PLSCO/Glowdeck_PCB/Images/Glowdeck PCB Image v1.01.jpg

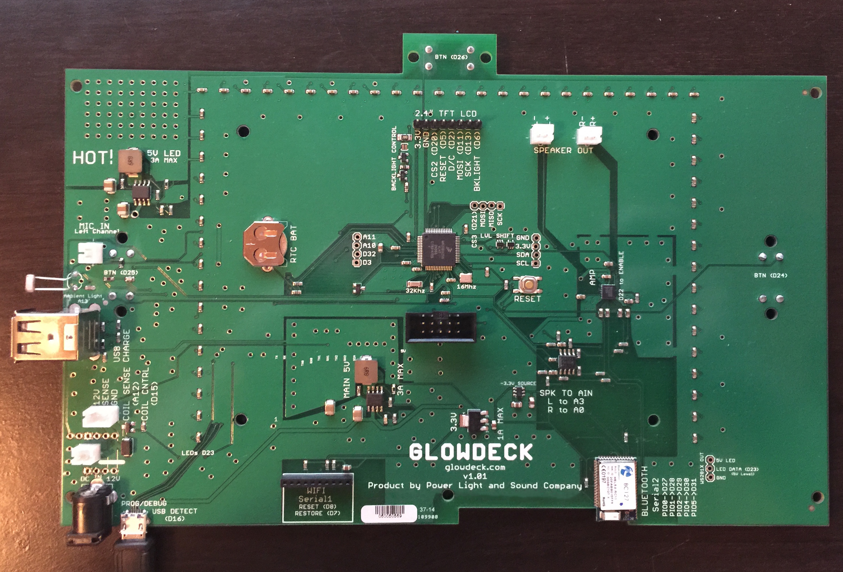
Images/Glowdeck PCB Image v1.01.jpg
