PLSCO/Glowdeck_PCB/README.md

# Glowdeck_PCB
Glowdeck circuit board design and layout
