PLSCO/Glowdeck_PCB/Schematic/Glowdeck PCB Schematic v1.01.pdf

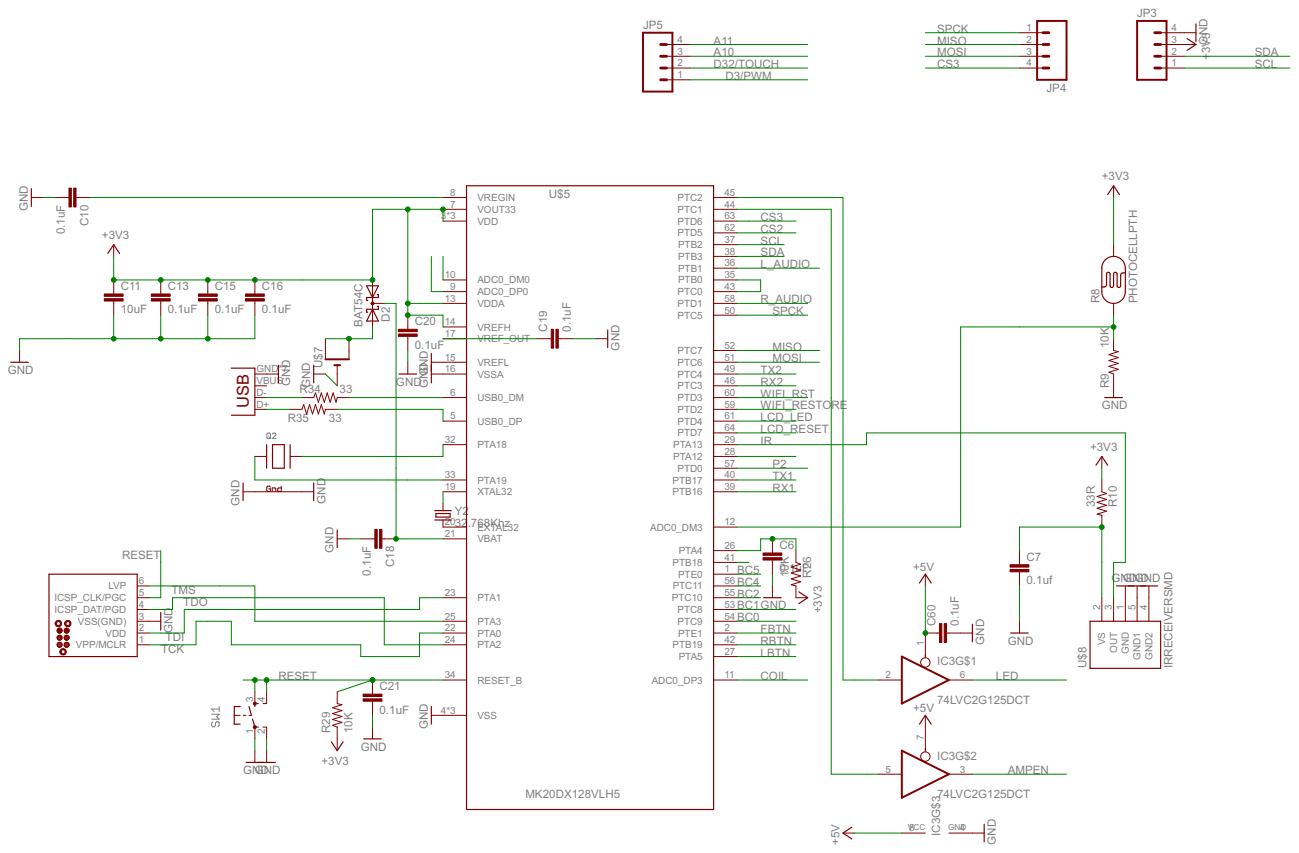
[picture p2: page 1]

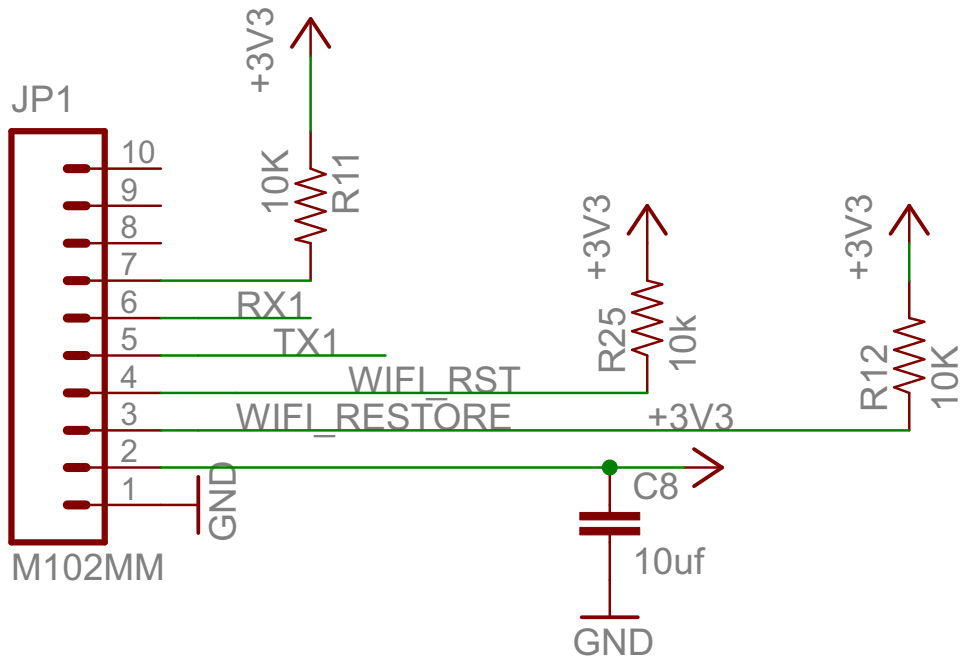
[picture p3: page 2]

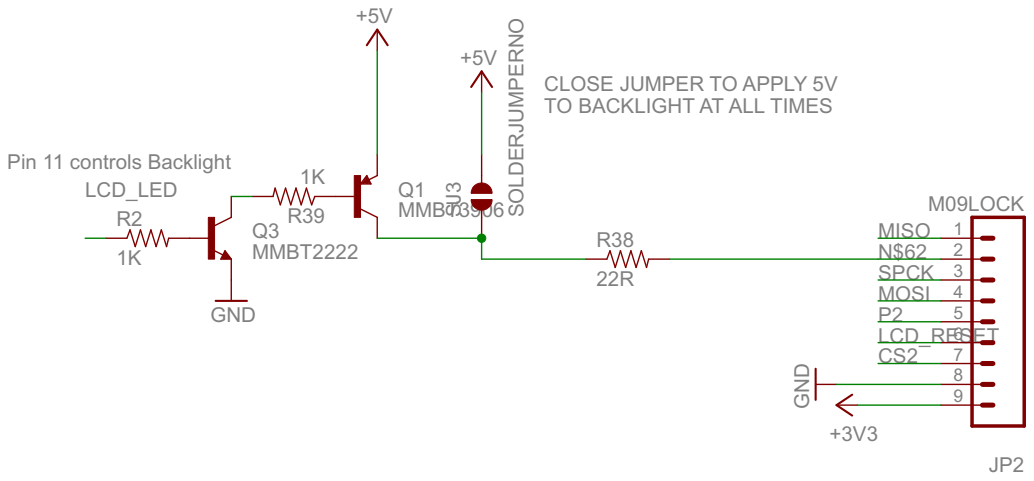
[picture p4: page 3]

CLOSE JUMPER TO APPLY 5V
TO BACKLIGHT AT ALL TIMES

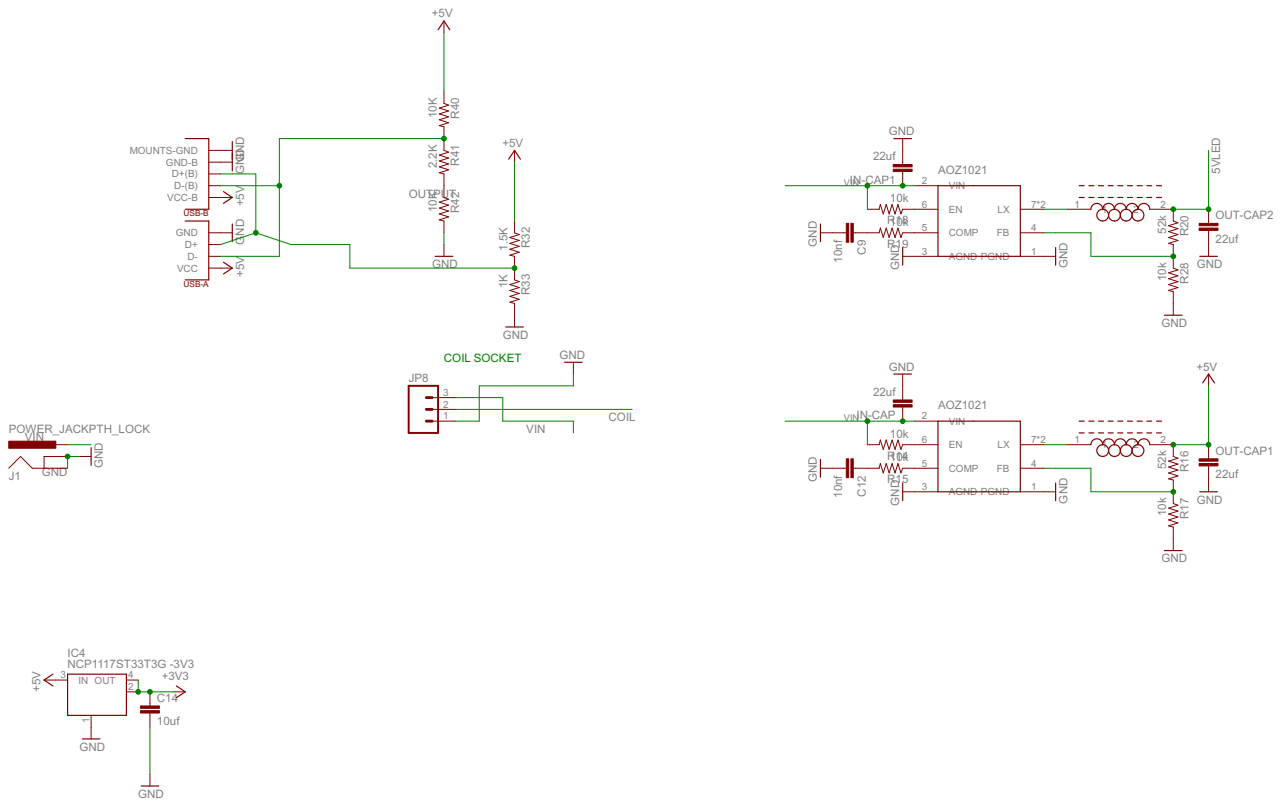
[picture p5: page 4]

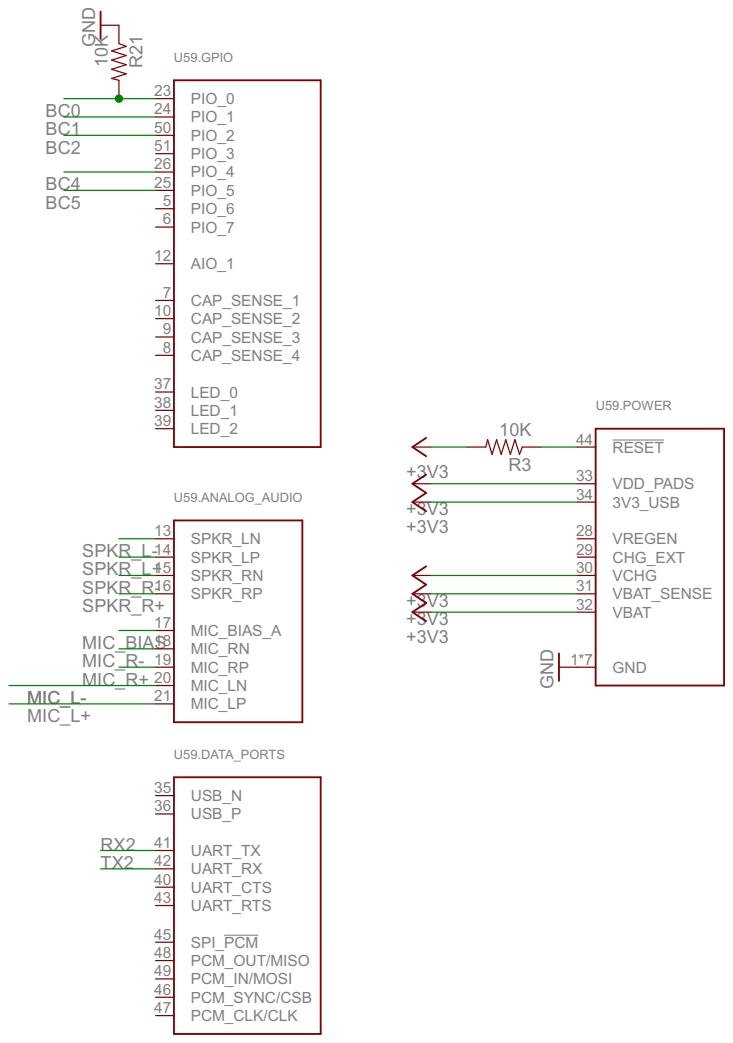
[picture p6: page 5]

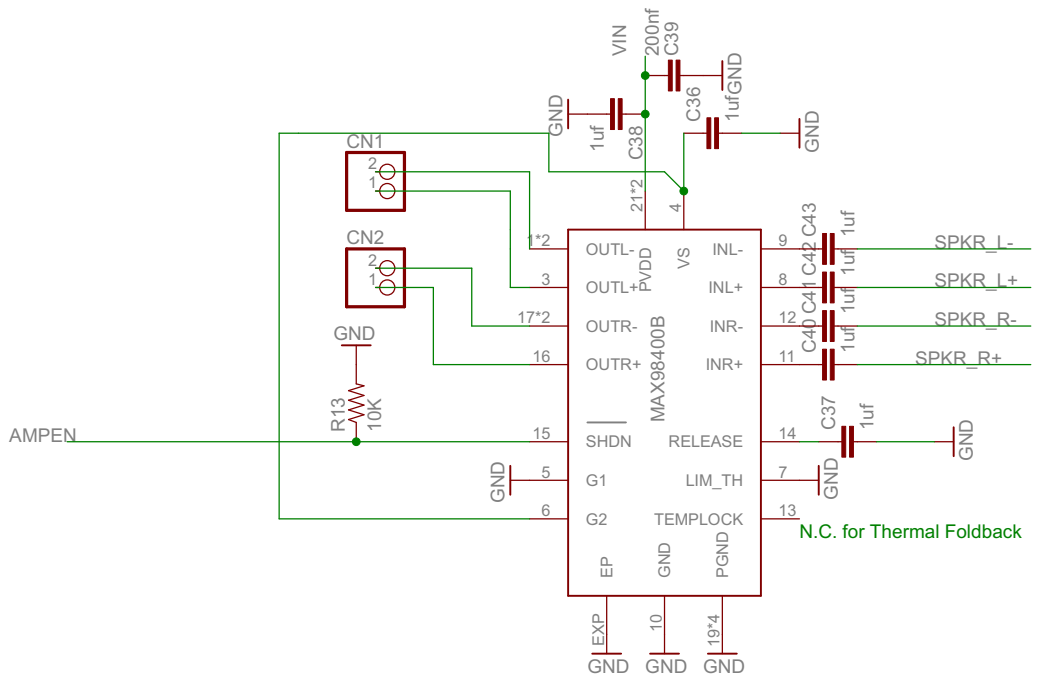
[picture p7: page 6]

1uf 1uf 1uf GND GND GND GND GND GND GND GND200nf 10K 1uf 1uf 1uf 1uf GND GND OUTL- 1*2 OUTL+ 3 OUTR- 17*2 OUTR+ 16 SHDN 15 G1 5 G2 6 TEMPLOCK 13 LIM_TH 7 RELEASE 14 INR+ 11 INR- 12 INL+ 8 INL- 9 VS 4 PVDD 21*2 GND 10 PGND 19*4 EP EXP MAX98400B C36 C37 C38 C39 R13 C40 C41 C42 C43 CN121 CN221 AMPEN SPKR_R+ SPKR_R- SPKR_L+ SPKR_L- VIN N.C. for Thermal Foldback

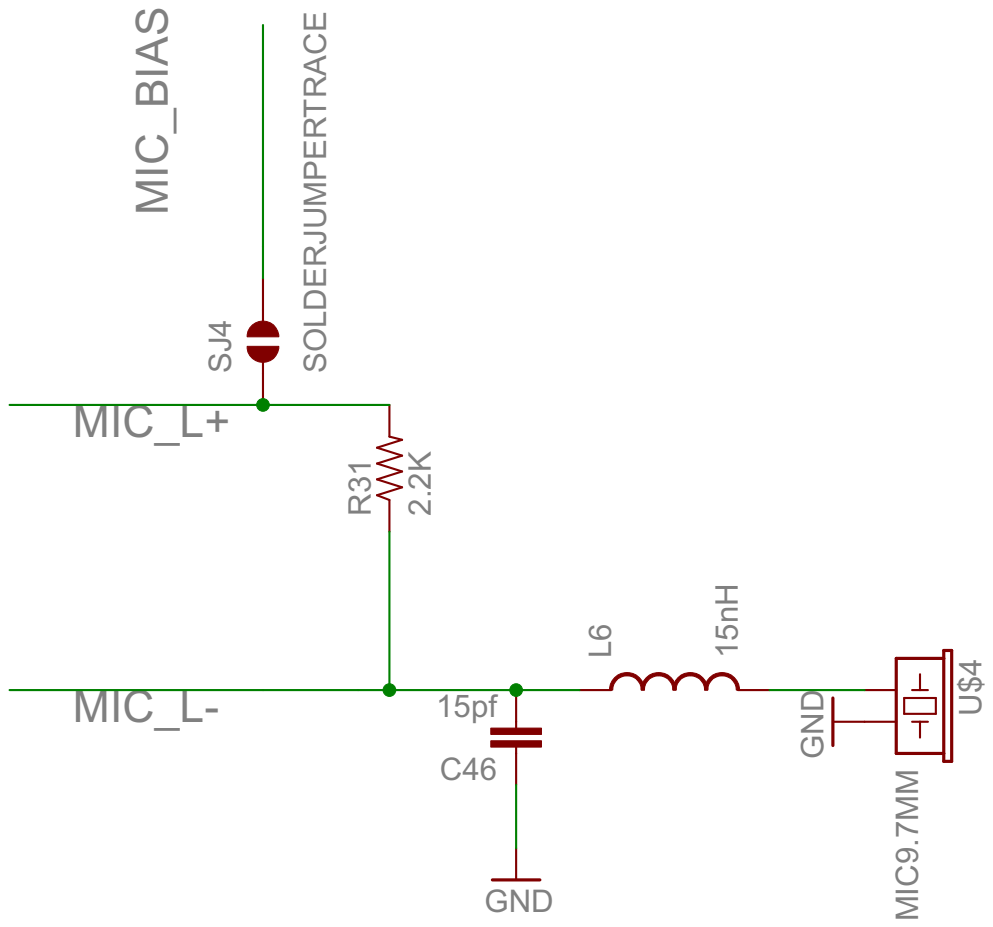
[picture p8: page 7]

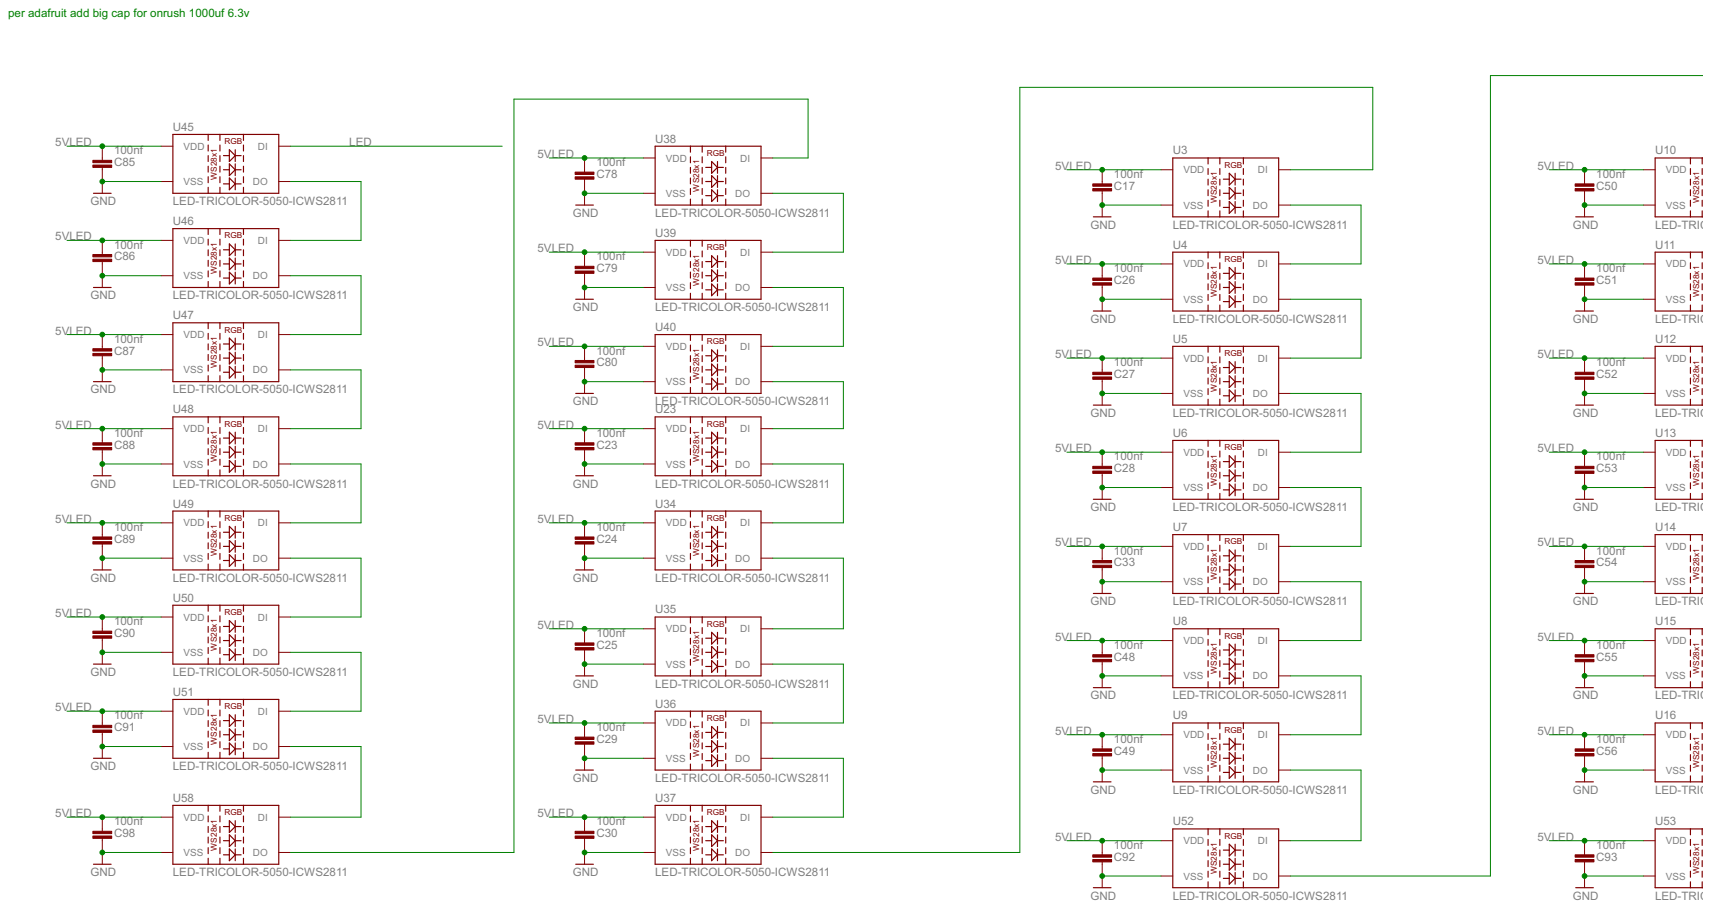
[picture p9: page 8]

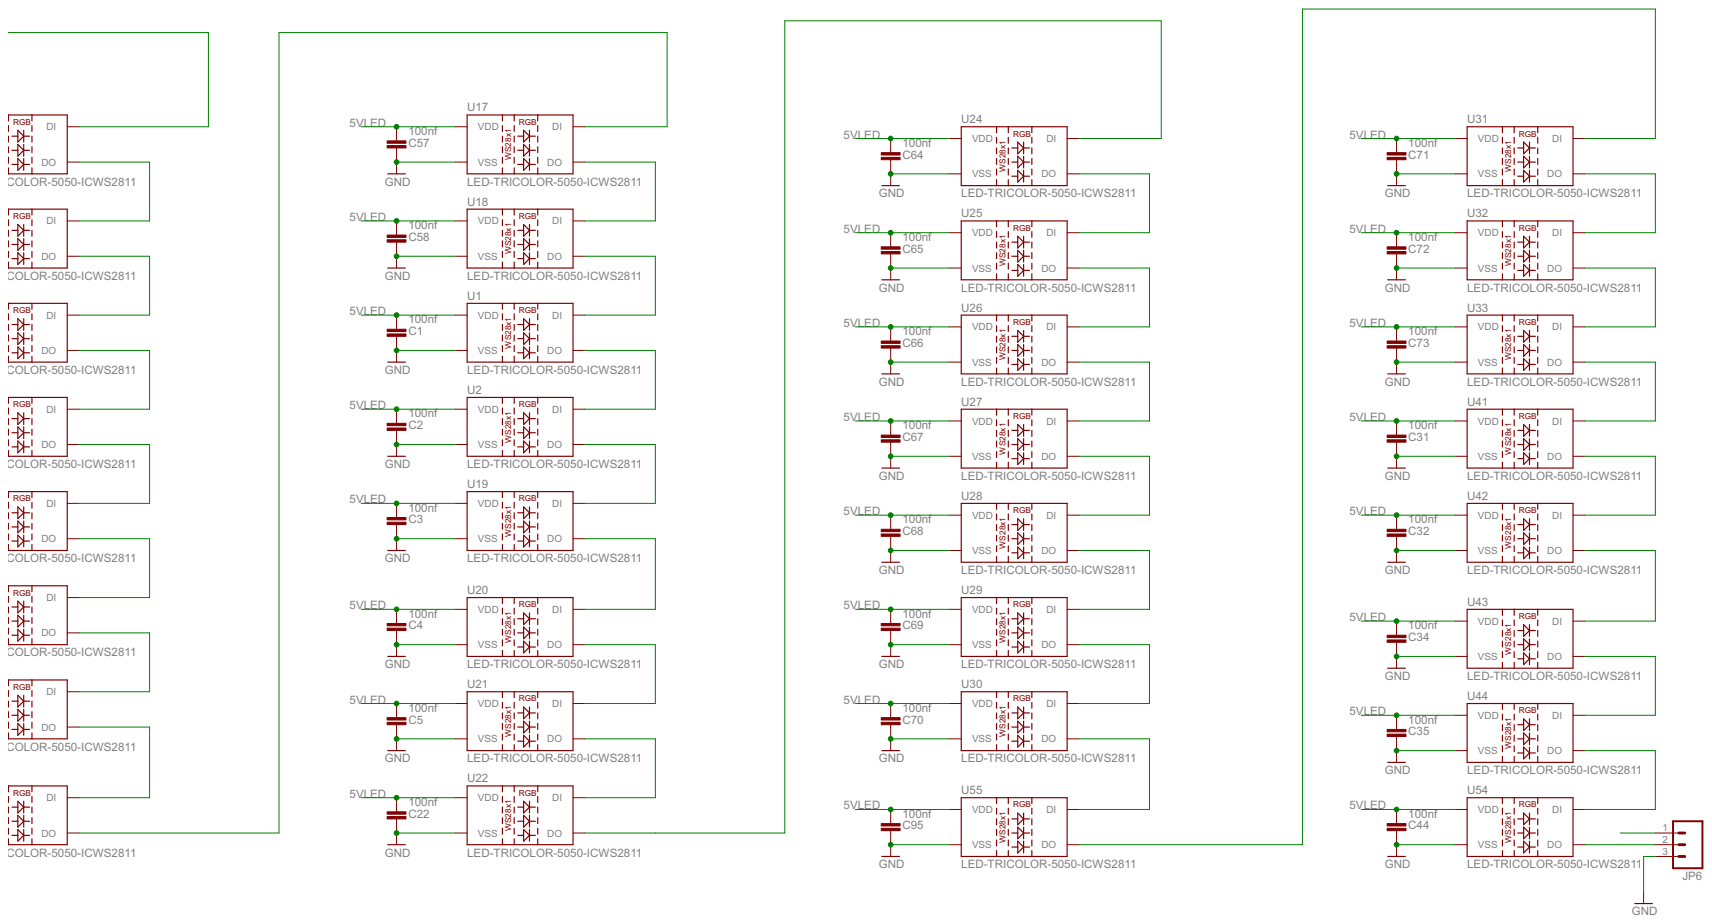
[picture p10: page 9]

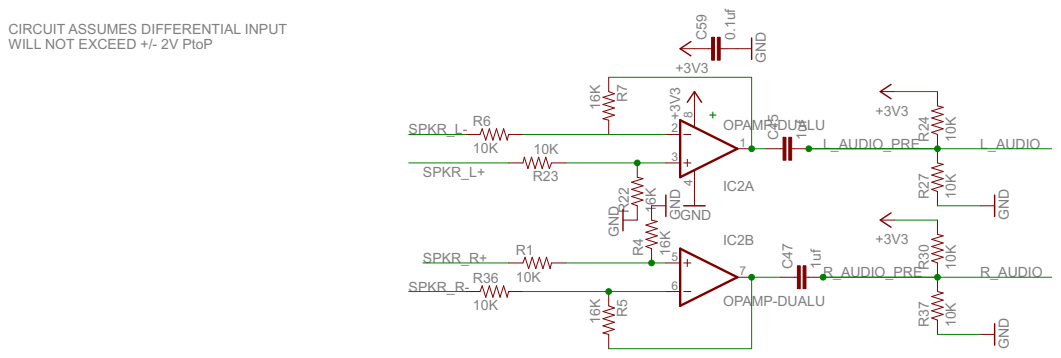
[picture p11: page 10]

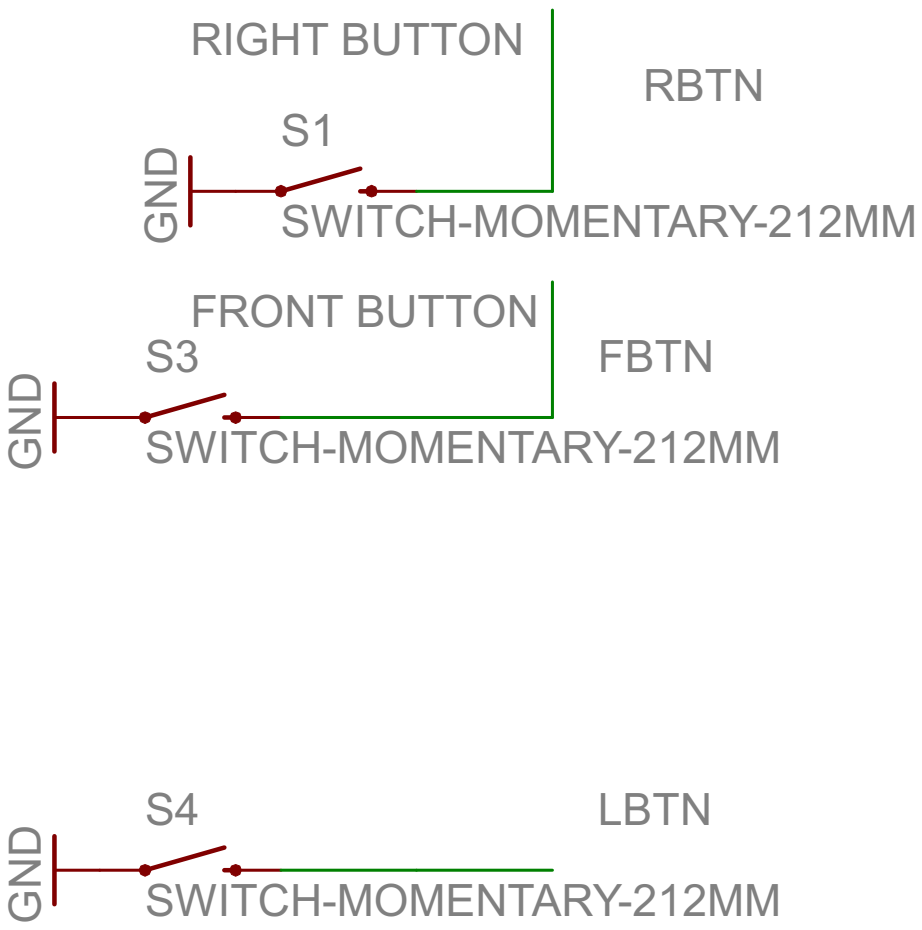
[picture p12: page 11]

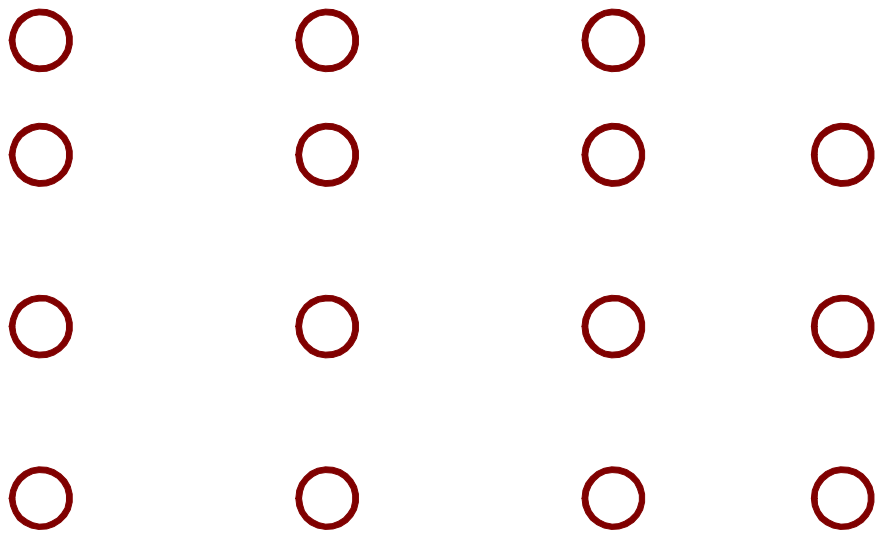
[picture p13: page 12]
