PLSCO/Glowdeck_PCB/Eagle/Glowdeck_beta_proto.brd

## EAGLE design Eagle/Glowdeck_beta_proto.brd (2017-09-16)

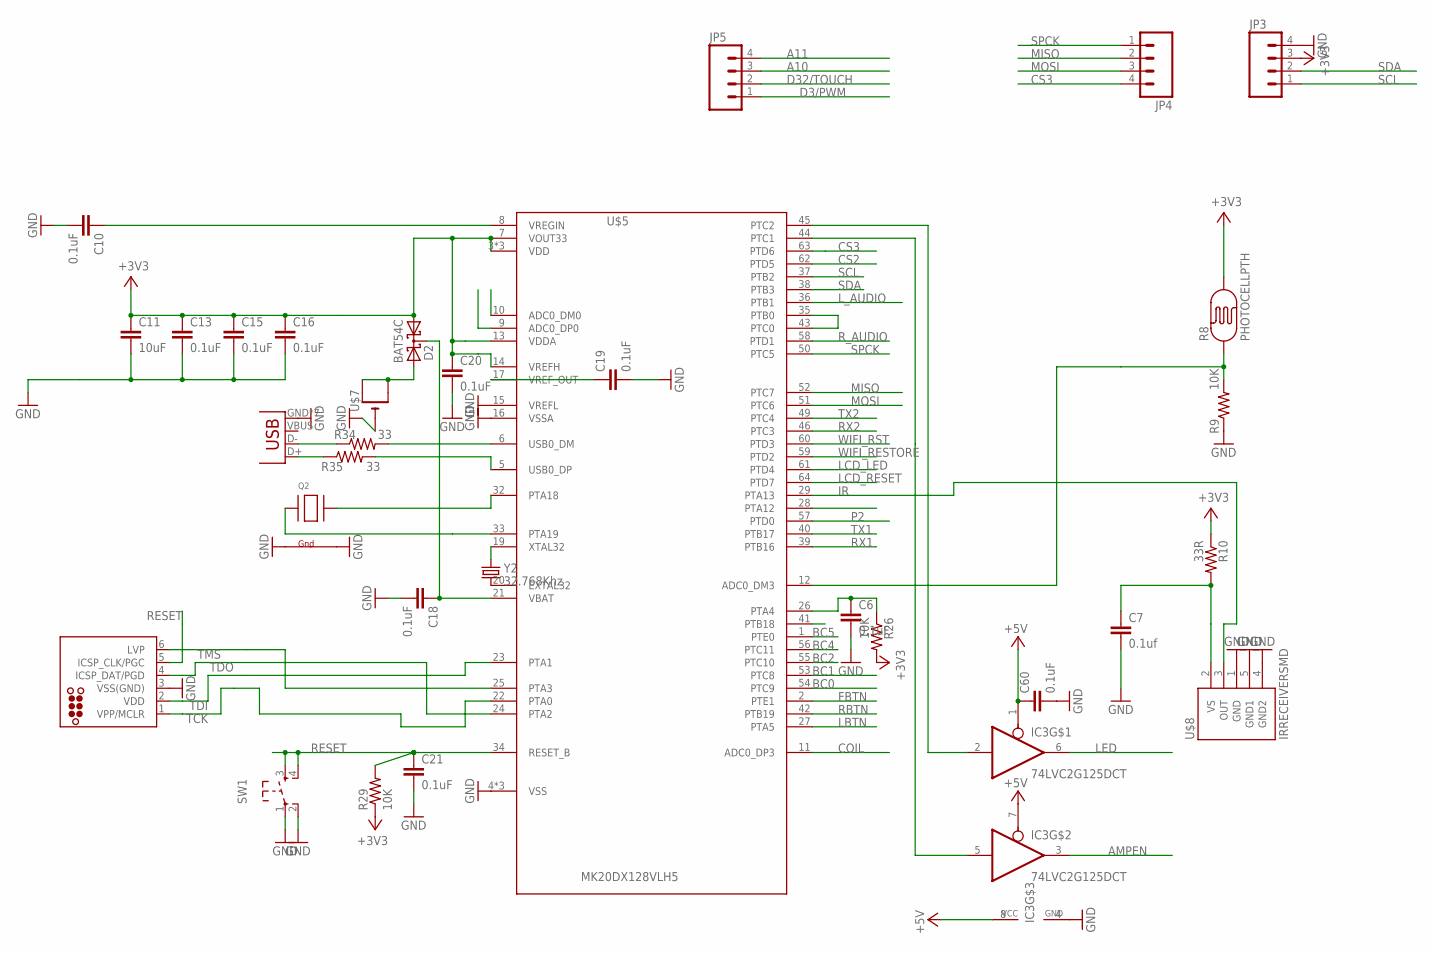
[picture p14: schematic Glowdeck_beta_proto.sch, sheet 1, Main]

Parts:
C6, C10, C13, C15, C16, C18, C19, C20, C21, C60: 0.1uF; 0603-CAP
C7: 0.1uf; 0603-CAP
C11: 10uF; 0805
D2: BAT54C; SOT23
IC3: 74LVC2G125DCT; SSOP08
J2: TC2030-MCP-NL
JP3, JP4, JP5: M04LOCK; 1X04_LOCK
Q2: XTAL-4-3225; NX3225
R8: PHOTOCELLPTH; PHOTOCELL
R9, R26, R29: 10K; 0603-RES
R10: 33R; 0603-RES
R34, R35: 33; 0603-RES
SW1: SW_TACT_4P; SW_TACT_SMALL
U$5: MK20DX128VLH5
U$7: CR1220THM; CR1220-THM
U$8: IRRECEIVERSMD; TSOP8523
X3: USB-MICROB
Y2: 32.768Khz; RESONATOR_EPSON_FC_145

Connections:
+3V3: C11.1, C13.1, C15.1, C16.1, C20.1, D2.1 (A1), JP3.3, R8.2, R10.1, R26.2, R29.1, U$5.3 (VDD), U$5.7 (VOUT33), U$5.13 (VDDA), U$5.14 (VREFH), U$5.30 (VDD), U$5.48 (VDD); also elsewhere on the board
+5V: C60.1, IC3.1 (OE), IC3.7 (OE), IC3.8 (VCC); also elsewhere on the board
A10: JP5.3, U$5.9 (ADC0_DP0)
A11: JP5.4, U$5.10 (ADC0_DM0)
AMPEN: IC3.3 (O); also elsewhere on the board
BC0: U$5.54 (PTC9); also elsewhere on the board
BC1: U$5.53 (PTC8); also elsewhere on the board
BC2: U$5.55 (PTC10); also elsewhere on the board
BC4: U$5.56 (PTC11); also elsewhere on the board
BC5: U$5.1 (PTE0); also elsewhere on the board
COIL: U$5.11 (ADC0_DP3); also elsewhere on the board
CS2: U$5.62 (PTD5); also elsewhere on the board
CS3: JP4.4, U$5.63 (PTD6)
D3/PWM: JP5.1, U$5.28 (PTA12)
D32/TOUCH: JP5.2, U$5.41 (PTB18)
FBTN: U$5.2 (PTE1); also elsewhere on the board
GND: C6.2, C7.2, C10.2, C11.2, C13.2, C15.2, C16.2, C18.2, C19.2, C20.2, C21.2, C60.2, IC3.4 (GND), J2.3 (VSS(GND)), JP3.4, Q2.2 (G2), Q2.4 (G1), R9.1, SW1.1, SW1.2, U$5.4 (VSS), U$5.15 (VREFL), U$5.16 (VSSA), U$5.31 (VSS), U$5.47 (VSS), U$7.-, U$8.1 (GND), U$8.4 (GND2), U$8.5 (GND1), X3.GND, X3.P1 (GND), X3.P2 (GND), X3.P3 (GND), X3.P4 (GND), X3.P5 (GND), X3.P6 (GND); also elsewhere on the board
IR: U$5.29 (PTA13), U$8.3 (OUT)
LBTN: U$5.27 (PTA5); also elsewhere on the board
LCD_LED: U$5.61 (PTD4); also elsewhere on the board
LCD_RESET: U$5.64 (PTD7); also elsewhere on the board
LED: IC3.6 (O); also elsewhere on the board
L_AUDIO: U$5.36 (PTB1); also elsewhere on the board
MISO: JP4.2, U$5.52 (PTC7); also elsewhere on the board
MOSI: JP4.3, U$5.51 (PTC6); also elsewhere on the board
unnamed: U$5.35 (PTB0), U$5.43 (PTC0)
unnamed: C7.1, R10.2, U$8.2 (VS)
unnamed: Q2.3 (X2), U$5.32 (PTA18)
unnamed: D2.2 (A2), U$7.+1 (+), U$7.+2 (+1)
unnamed: C6.1, R26.1, U$5.26 (PTA4)
unnamed: U$5.20 (EXTAL32), Y2.P$2 (2)
unnamed: C19.1, U$5.17 (VREF_OUT)
unnamed: C10.1, U$5.8 (VREGIN)
unnamed: C18.1, D2.3 (CC), U$5.21 (VBAT)
unnamed: R34.2, U$5.6 (USB0_DM)
unnamed: R35.2, U$5.5 (USB0_DP)
unnamed: U$5.19 (XTAL32), Y2.P$1 (1)
unnamed: Q2.1 (X1), U$5.33 (PTA19)
unnamed: R8.1, R9.2, U$5.12 (ADC0_DM3)
unnamed: IC3.5 (I), U$5.44 (PTC1)
unnamed: IC3.2 (I), U$5.45 (PTC2)
unnamed: R34.1, X3.D-
unnamed: R35.1, X3.D+
P2: U$5.57 (PTD0); also elsewhere on the board
RBTN: U$5.42 (PTB19); also elsewhere on the board
RESET: C21.1, J2.5 (ICSP_CLK/PGC), R29.2, SW1.3, SW1.4, U$5.34 (RESET_B)
RX1: U$5.39 (PTB16); also elsewhere on the board
RX2: U$5.46 (PTC3); also elsewhere on the board
R_AUDIO: U$5.58 (PTD1); also elsewhere on the board
SCL: JP3.1, U$5.37 (PTB2)
SDA: JP3.2, U$5.38 (PTB3)
SPCK: JP4.1, U$5.50 (PTC5); also elsewhere on the board
TCK: J2.1 (VPP/MCLR), U$5.22 (PTA0)
TDI: J2.2 (VDD), U$5.23 (PTA1)
TDO: J2.4 (ICSP_DAT/PGD), U$5.24 (PTA2)
TMS: J2.6 (LVP), U$5.25 (PTA3)
TX1: U$5.40 (PTB17); also elsewhere on the board
TX2: U$5.49 (PTC4); also elsewhere on the board
WIFI_RESTORE: U$5.59 (PTD2); also elsewhere on the board
WIFI_RST: U$5.60 (PTD3); also elsewhere on the board

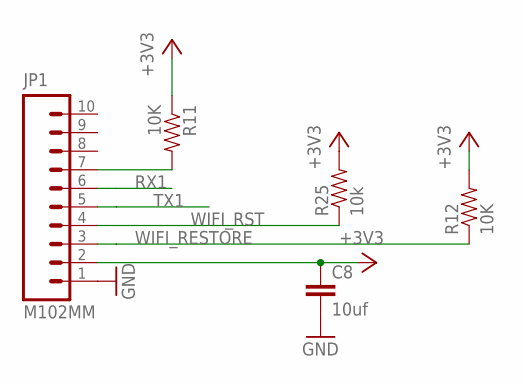
[picture p15: schematic Glowdeck_beta_proto.sch, sheet 2, Wifi]

Parts:
C8: 10uf; 0805
JP1: M102MM; 1X10-2MM
R11, R12: 10K; 0603-RES
R25: 10k; 0603-RES

Connections:
+3V3: C8.1, JP1.2, R11.1, R12.2, R25.2; also elsewhere on the board
GND: C8.2, JP1.1; also elsewhere on the board
unnamed: JP1.7, R11.2
RX1: JP1.6; also elsewhere on the board
TX1: JP1.5; also elsewhere on the board
WIFI_RESTORE: JP1.3, R12.1; also elsewhere on the board
WIFI_RST: JP1.4, R25.1; also elsewhere on the board

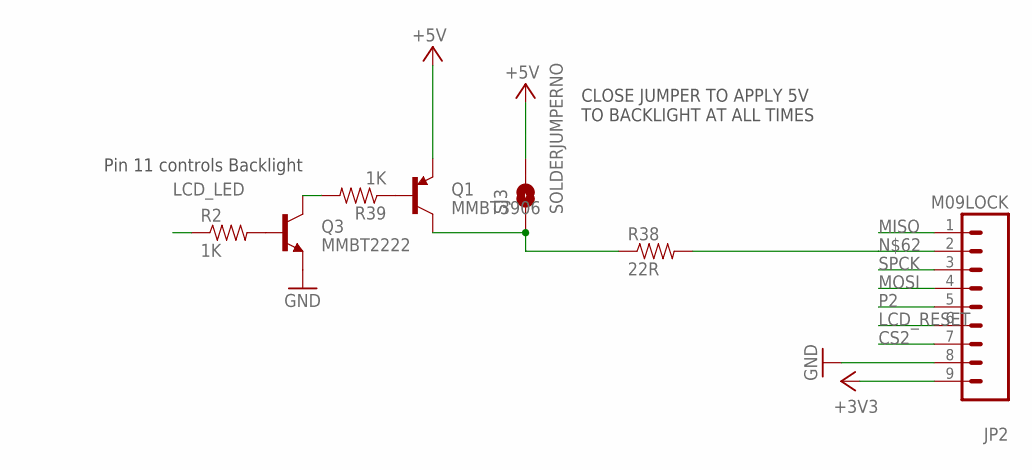
[picture p16: schematic Glowdeck_beta_proto.sch, sheet 3, LCD/SD]

Parts:
JP2: M09LOCK; 1X09_LOCK
Q1: MMBT3906; SOT23-3
Q3: MMBT2222; SOT23-3
R2, R39: 1K; 0603-RES
R38: 22R; 1206
SJ3: SOLDERJUMPERNO; SJ_2S-NO

Connections:
+3V3: JP2.9; also elsewhere on the board
+5V: Q1.2 (E), SJ3.2; also elsewhere on the board
BACKLIGHT: Q1.3 (C), R38.1, SJ3.1
CS2: JP2.7; also elsewhere on the board
GND: JP2.8, Q3.2 (E); also elsewhere on the board
LCD_LED: R2.1; also elsewhere on the board
LCD_RESET: JP2.6; also elsewhere on the board
MISO: JP2.1; also elsewhere on the board
MOSI: JP2.4; also elsewhere on the board
unnamed: Q1.1 (B), R39.1
unnamed: JP2.2, R38.2
unnamed: Q3.3 (C), R39.2
unnamed: Q3.1 (B), R2.2
P2: JP2.5; also elsewhere on the board
SPCK: JP2.3; also elsewhere on the board

Notes on the sheet:
CLOSE JUMPER TO APPLY 5V TO BACKLIGHT AT ALL TIMES
Pin 11 controls Backlight

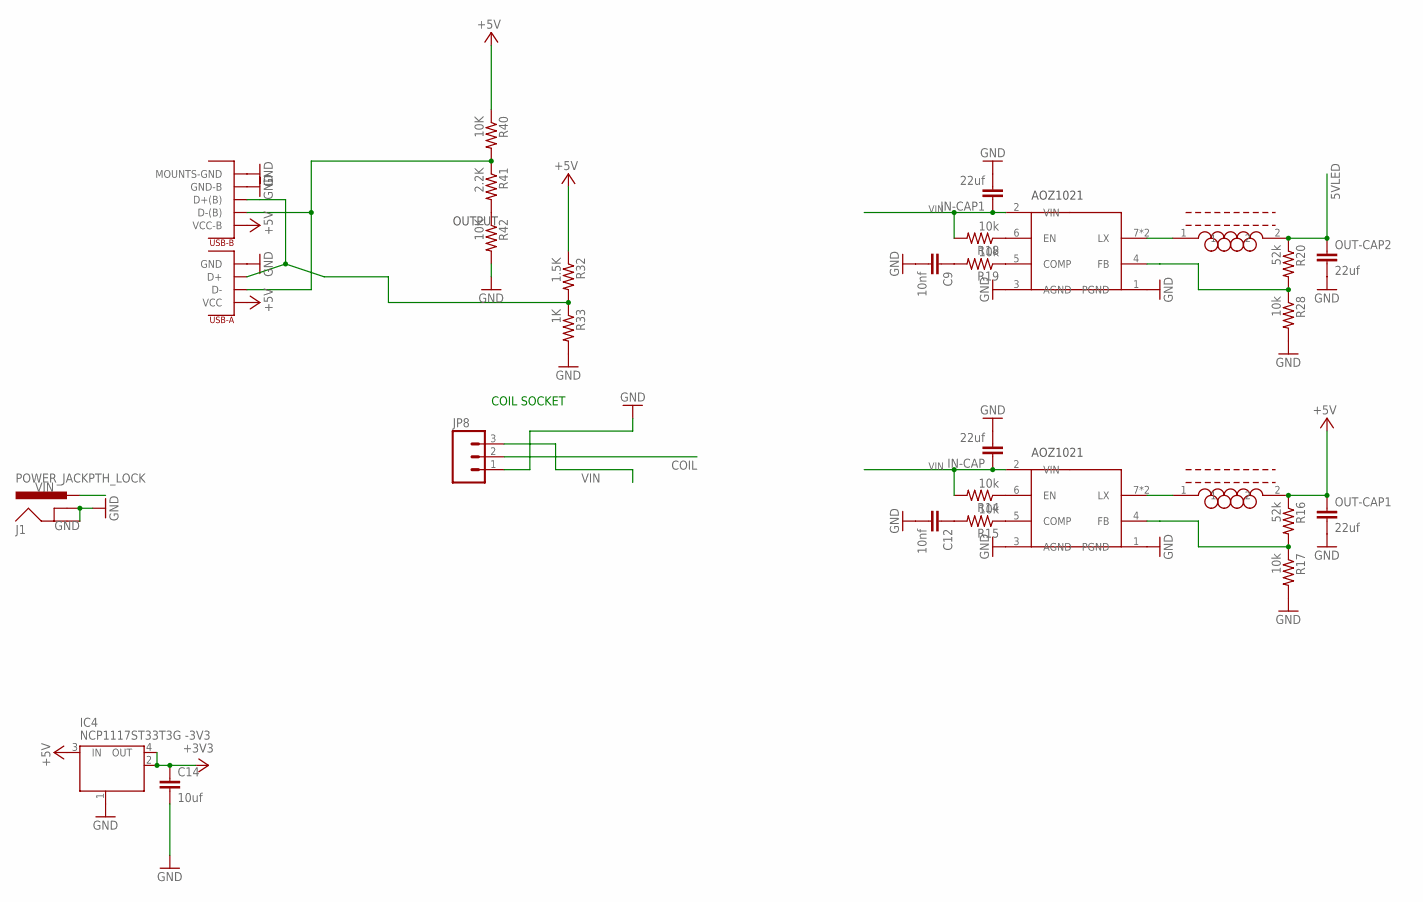
[picture p17: schematic Glowdeck_beta_proto.sch, sheet 4, VREG]

Parts:
AOZ1015AI, AOZ1015AI1: AOZ1021; SO-08
C9, C12: 10nf; 0603-CAP
C14: 10uf; 0805
IC4: NCP1117ST33T3G -3V3; SOT223
IN-CAP, IN-CAP1: 22uf; 1210
J1: POWER_JACKPTH_LOCK; POWER_JACK_PTH_LOCK
JP8: M03JST-PTH; JST-3-PTH
OUT-CAP1, OUT-CAP2: 22uf; 1210
R14, R15, R17, R18, R19, R28: 10k; 0603-RES
R16, R20: 52k; 0603-RES
R32: 1.5K; 0603-RES
R33: 1K; 0603-RES
R40, R42: 10K; 0603-RES
R41: 2.2K; 0603-RES
U$1, U$2: SRP7030F; SRP7030
U$6: DUAL-PORT-USB-REC; DUAL-PORT-USB

Connections:
5VLED: OUT-CAP2.1, R20.1, U$2.2; also elsewhere on the board
+3V3: C14.1, IC4.2 (OUT), IC4.4 (OUT); also elsewhere on the board
+5V: IC4.3 (IN), OUT-CAP1.1, R16.1, R32.1, R40.1, U$1.2, U$6.P$10 (VCC-B), U$6.P$12 (VCC); also elsewhere on the board
COIL: JP8.2; also elsewhere on the board
GND: AOZ1015AI.1 (PGND), AOZ1015AI.3 (AGND), AOZ1015AI1.1 (PGND), AOZ1015AI1.3 (AGND), C9.2, C12.2, C14.2, IC4.1 (GND/ADJ), IN-CAP.2, IN-CAP1.2, J1.GND, J1.GNDBREAK, JP8.1, OUT-CAP1.2, OUT-CAP2.2, R17.2, R28.2, R33.2, R42.2, U$6.GND (MOUNTS-GND), U$6.P$2 (MOUNTS-GND), U$6.P$3 (MOUNTS-GND), U$6.P$4 (MOUNTS-GND), U$6.P$9 (GND-B), U$6.P$11 (GND); also elsewhere on the board
LOUT: AOZ1015AI.7 (LX), AOZ1015AI.8 (LX), U$1.1
LOUT1: AOZ1015AI1.7 (LX), AOZ1015AI1.8 (LX), U$2.1
unnamed: AOZ1015AI1.6 (EN), R18.1
unnamed: AOZ1015AI.6 (EN), R14.1
unnamed: AOZ1015AI1.5 (COMP), R19.1
unnamed: C9.1, R19.2
unnamed: AOZ1015AI.5 (COMP), R15.1
unnamed: C12.1, R15.2
unnamed: AOZ1015AI.4 (FB), R16.2, R17.1
unnamed: AOZ1015AI1.4 (FB), R20.2, R28.1
unnamed: R32.2, R33.1, U$6.P$6 (D+(B)), U$6.P$8 (D+)
unnamed: R41.2, R42.1
unnamed: R40.2, R41.1, U$6.P$5 (D-(B)), U$6.P$7 (D-)
VIN: AOZ1015AI.2 (VIN), AOZ1015AI1.2 (VIN), IN-CAP.1, IN-CAP1.1, J1.PWR, JP8.3, R14.2, R18.2; also elsewhere on the board

Notes on the sheet:
OUTPUT
COIL SOCKET

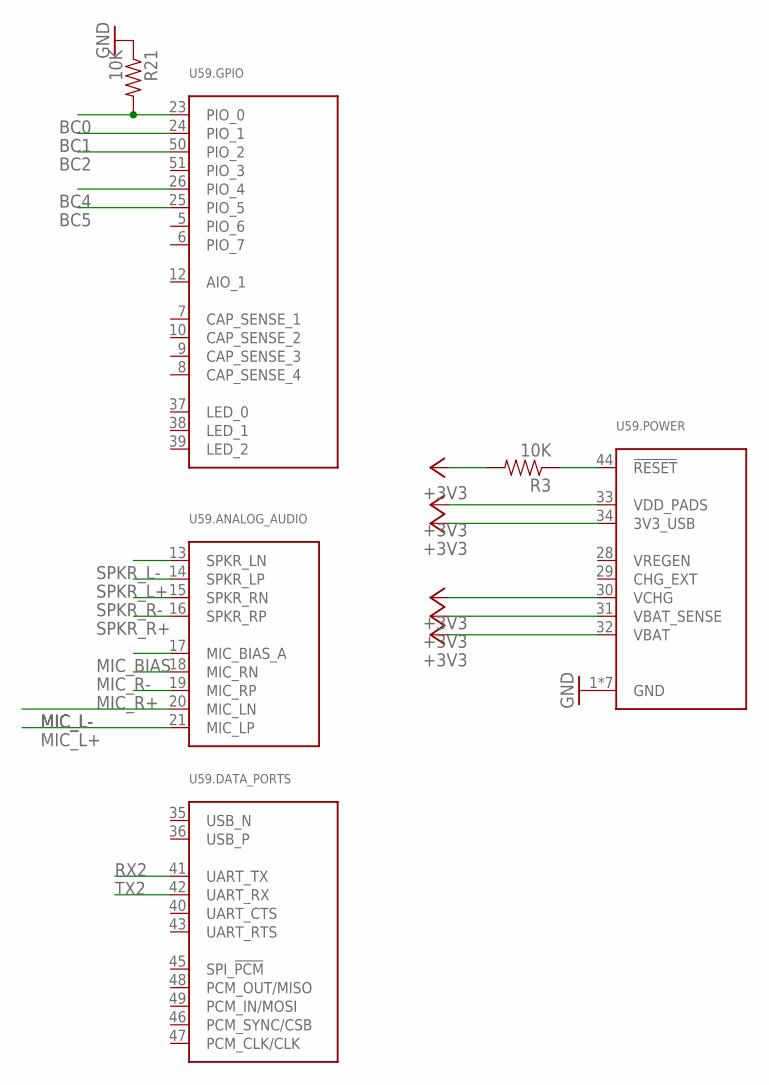
[picture p18: schematic Glowdeck_beta_proto.sch, sheet 5, BC127]

Parts:
R3, R21: 10K; 0603-RES
U59: BC127EXTRA_PASTE; BC127_XTRA_PASTE

Connections:
+3V3: R3.2, U59.30 (VCHG), U59.31 (VBAT_SENSE), U59.32 (VBAT), U59.33 (VDD_PADS), U59.34 (3V3_USB); also elsewhere on the board
BC0: R21.2, U59.23 (PIO_0); also elsewhere on the board
BC1: U59.24 (PIO_1); also elsewhere on the board
BC2: U59.50 (PIO_2); also elsewhere on the board
BC4: U59.26 (PIO_4); also elsewhere on the board
BC5: U59.25 (PIO_5); also elsewhere on the board
GND: R21.1, U59.1 (GND), U59.2 (GND), U59.3 (GND), U59.4 (GND), U59.11 (GND), U59.22 (GND), U59.27 (GND); also elsewhere on the board
MIC_BIAS: U59.17 (MIC_BIAS_A); also elsewhere on the board
MIC_L+: U59.21 (MIC_LP); also elsewhere on the board
MIC_L-: U59.20 (MIC_LN); also elsewhere on the board
MIC_R+: U59.19 (MIC_RP)
MIC_R-: U59.18 (MIC_RN)
unnamed: R3.1, U59.44 (!RESET)
RX2: U59.41 (UART_TX); also elsewhere on the board
SPKR_L+: U59.14 (SPKR_LP); also elsewhere on the board
SPKR_L-: U59.13 (SPKR_LN); also elsewhere on the board
SPKR_R+: U59.16 (SPKR_RP); also elsewhere on the board
SPKR_R-: U59.15 (SPKR_RN); also elsewhere on the board
TX2: U59.42 (UART_RX); also elsewhere on the board

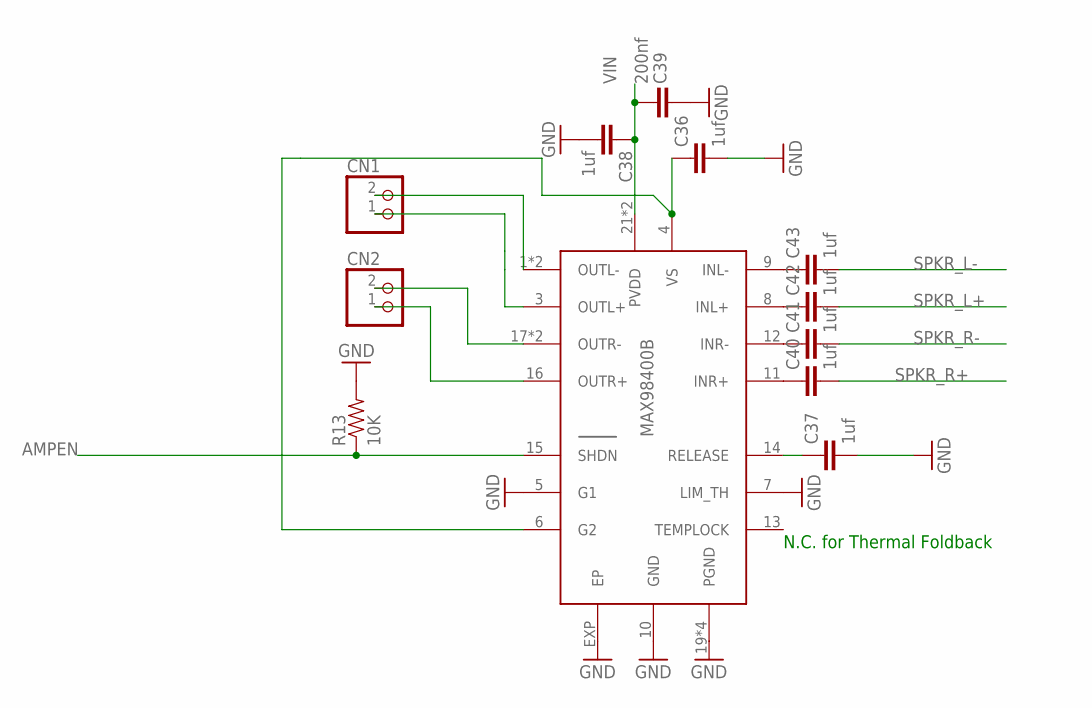
[picture p19: schematic Glowdeck_beta_proto.sch, sheet 6, AMP]

Parts:
C36, C37, C38, C40, C41, C42, C43: 1uf; 0805
C39: 200nf; 0603-CAP
CN1, CN2: JST_2PIN-THM; JST-PH-2-THM
R13: 10K; 0603-RES
U$3: MAX98400B; TQFN24-EP

Connections:
AMPEN: R13.1, U$3.15 (SHDN); also elsewhere on the board
GND: C36.2, C37.2, C38.2, C39.1, R13.2, U$3.5 (G1), U$3.7 (LIM_TH), U$3.10 (GND), U$3.19 (PGND), U$3.20 (PGND), U$3.23 (PGND), U$3.24 (PGND), U$3.EXP (EP); also elsewhere on the board
unnamed: C40.1, U$3.11 (INR+)
unnamed: C41.1, U$3.12 (INR-)
unnamed: C42.1, U$3.8 (INL+)
unnamed: C43.1, U$3.9 (INL-)
unnamed: CN2.1 (2), U$3.16 (OUTR+)
unnamed: CN2.2 (1), U$3.17 (OUTR-), U$3.18 (OUTR-)
unnamed: CN1.1 (2), U$3.3 (OUTL+)
unnamed: CN1.2 (1), U$3.1 (OUTL-), U$3.2 (OUTL-)
unnamed: C37.1, U$3.14 (RELEASE)
unnamed: C36.1, U$3.4 (VS), U$3.6 (G2)
SPKR_L+: C42.2; also elsewhere on the board
SPKR_L-: C43.2; also elsewhere on the board
SPKR_R+: C40.2; also elsewhere on the board
SPKR_R-: C41.2; also elsewhere on the board
VIN: C38.1, C39.2, U$3.21 (PVDD), U$3.22 (PVDD); also elsewhere on the board

Notes on the sheet:
N.C. for Thermal Foldback

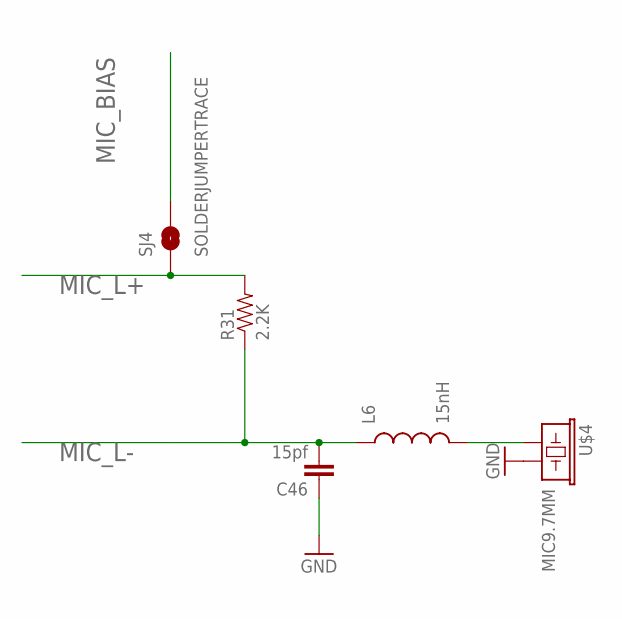
[picture p20: schematic Glowdeck_beta_proto.sch, sheet 7, MIC]

Parts:
C46: 15pf; 0805
L6: 15nH; 0603
R31: 2.2K; 0603-RES
SJ4: SOLDERJUMPERTRACE; SJ_2S-TRACE
U$4: MIC9.7MM; MIC-9.7MM

Connections:
GND: C46.1, U$4.2; also elsewhere on the board
MIC_BIAS: SJ4.2; also elsewhere on the board
MIC_L+: R31.2, SJ4.1; also elsewhere on the board
MIC_L-: C46.2, L6.1, R31.1; also elsewhere on the board
unnamed: L6.2, U$4.1

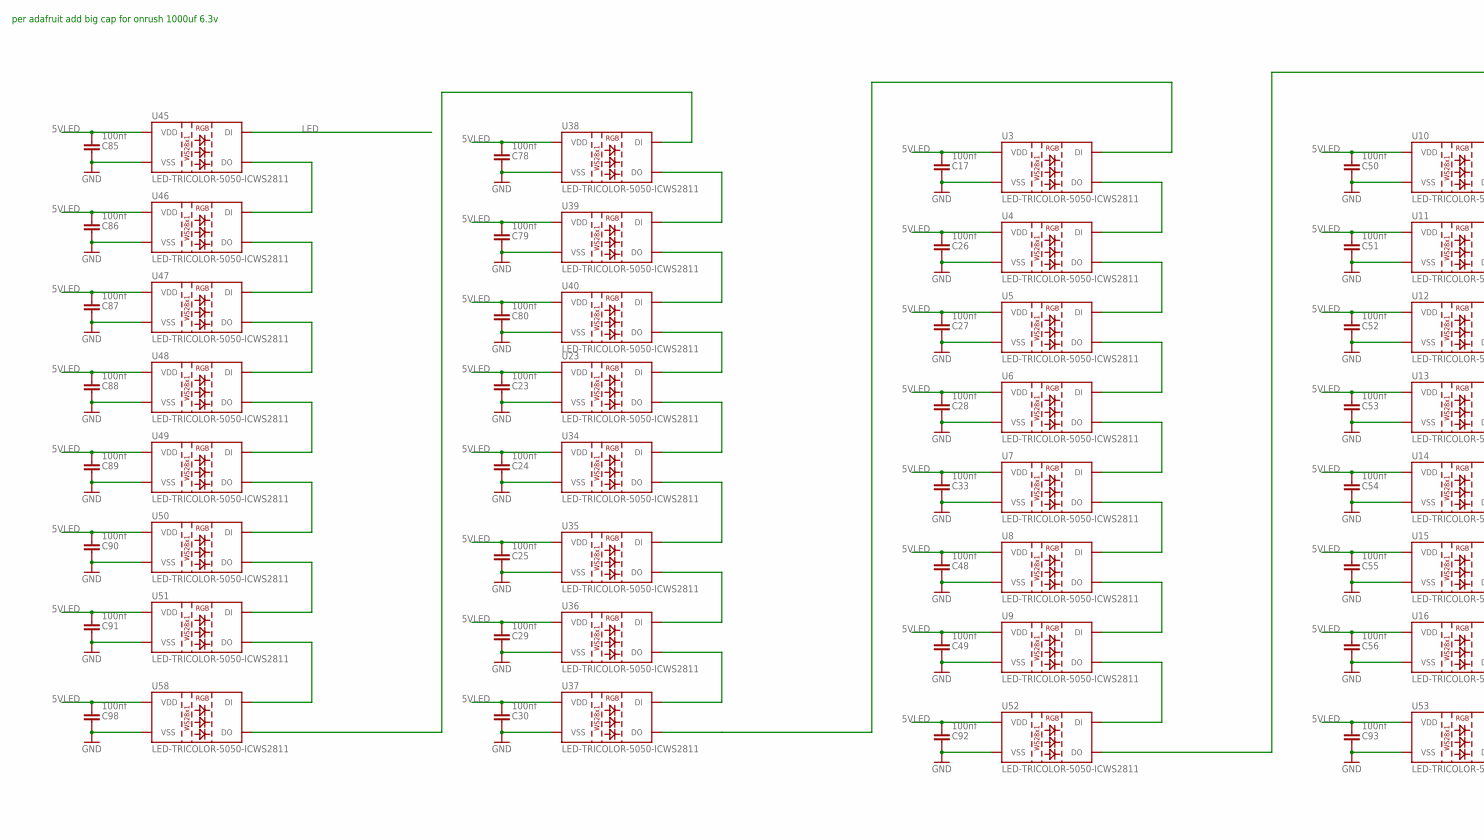
[picture p21: schematic Glowdeck_beta_proto.sch, sheet 8, LEDs, part in row 1, column 1]

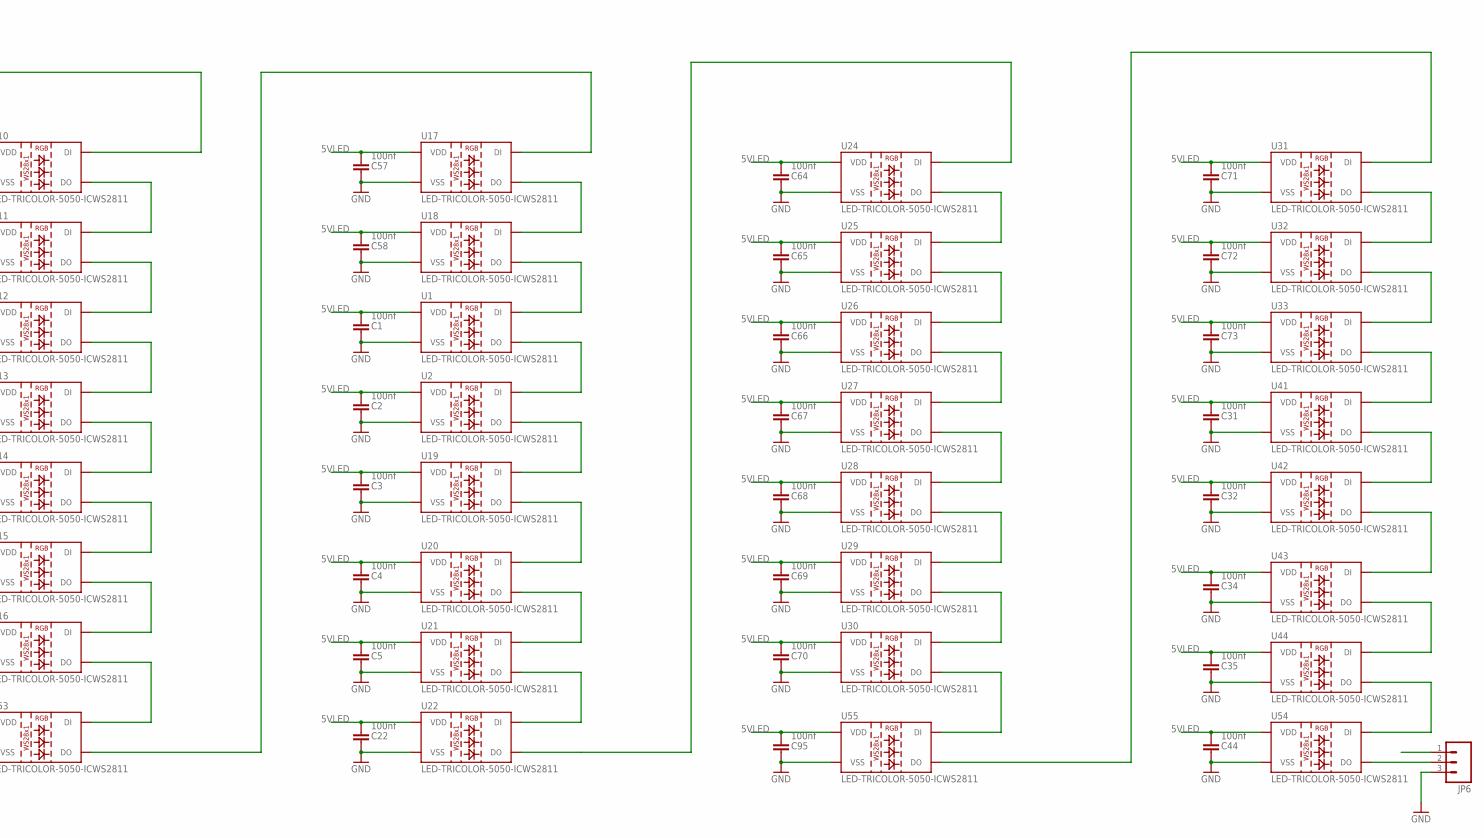
[picture p22: schematic Glowdeck_beta_proto.sch, sheet 8, LEDs, part in row 1, column 2]

Parts:
C1, C2, C3, C4, C5, C17, C22, C23, C24, C25, C26, C27, C28, C29, C30, C31, C32, C33, C34, C35, C44, C48, C49, C50, C51, C52, C53, C54, C55, C56, C57, C58, C64, C65, C66, C67, C68, C69, C70, C71, C72, C73, C78, C79, C80, C85, C86, C87, C88, C89, C90, C91, C92, C93, C95, C98: 100nf; 0603-CAP
JP6: M03LOCK; 1X03_LOCK
U1, U2, U3, U4, U5, U6, U7, U8, U9, U10, U11, U12, U13, U14, U15, U16, U17, U18, U19, U20, U21, U22, U23, U24, U25, U26, U27, U28, U29, U30, U31, U32, U33, U34, U35, U36, U37, U38, U39, U40, U41, U42, U43, U44, U45, U46, U47, U48, U49, U50, U51, U52, U53, U54, U55, U58: LED-TRICOLOR-5050-ICWS2811; LED-TRICOLOR-5050-IC

Connections:
5VLED: C1.2, C2.2, C3.2, C4.2, C5.2, C17.2, C22.2, C23.2, C24.2, C25.2, C26.2, C27.2, C28.2, C29.2, C30.2, C31.2, C32.2, C33.2, C34.2, C35.2, C44.2, C48.2, C49.2, C50.2, C51.2, C52.2, C53.2, C54.2, C55.2, C56.2, C57.2, C58.2, C64.2, C65.2, C66.2, C67.2, C68.2, C69.2, C70.2, C71.2, C72.2, C73.2, C78.2, C79.2, C80.2, C85.2, C86.2, C87.2, C88.2, C89.2, C90.2, C91.2, C92.2, C93.2, C95.2, C98.2, JP6.1, U1.1 (VDD), U2.1 (VDD), U3.1 (VDD), U4.1 (VDD), U5.1 (VDD), U6.1 (VDD), U7.1 (VDD), U8.1 (VDD), U9.1 (VDD), U10.1 (VDD), U11.1 (VDD), U12.1 (VDD), U13.1 (VDD), U14.1 (VDD), U15.1 (VDD), U16.1 (VDD), U17.1 (VDD), U18.1 (VDD), U19.1 (VDD), U20.1 (VDD), U21.1 (VDD), U22.1 (VDD), U23.1 (VDD), U24.1 (VDD), U25.1 (VDD), U26.1 (VDD), U27.1 (VDD), U28.1 (VDD), U29.1 (VDD), U30.1 (VDD), U31.1 (VDD), U32.1 (VDD), U33.1 (VDD), U34.1 (VDD), U35.1 (VDD), U36.1 (VDD), U37.1 (VDD), U38.1 (VDD), U39.1 (VDD), U40.1 (VDD), U41.1 (VDD), U42.1 (VDD), U43.1 (VDD), U44.1 (VDD), U45.1 (VDD), U46.1 (VDD), U47.1 (VDD), U48.1 (VDD), U49.1 (VDD), U50.1 (VDD), U51.1 (VDD), U52.1 (VDD), U53.1 (VDD), U54.1 (VDD), U55.1 (VDD), U58.1 (VDD); also elsewhere on the board
GND: C1.1, C2.1, C3.1, C4.1, C5.1, C17.1, C22.1, C23.1, C24.1, C25.1, C26.1, C27.1, C28.1, C29.1, C30.1, C31.1, C32.1, C33.1, C34.1, C35.1, C44.1, C48.1, C49.1, C50.1, C51.1, C52.1, C53.1, C54.1, C55.1, C56.1, C57.1, C58.1, C64.1, C65.1, C66.1, C67.1, C68.1, C69.1, C70.1, C71.1, C72.1, C73.1, C78.1, C79.1, C80.1, C85.1, C86.1, C87.1, C88.1, C89.1, C90.1, C91.1, C92.1, C93.1, C95.1, C98.1, JP6.3, U1.3 (VSS), U2.3 (VSS), U3.3 (VSS), U4.3 (VSS), U5.3 (VSS), U6.3 (VSS), U7.3 (VSS), U8.3 (VSS), U9.3 (VSS), U10.3 (VSS), U11.3 (VSS), U12.3 (VSS), U13.3 (VSS), U14.3 (VSS), U15.3 (VSS), U16.3 (VSS), U17.3 (VSS), U18.3 (VSS), U19.3 (VSS), U20.3 (VSS), U21.3 (VSS), U22.3 (VSS), U23.3 (VSS), U24.3 (VSS), U25.3 (VSS), U26.3 (VSS), U27.3 (VSS), U28.3 (VSS), U29.3 (VSS), U30.3 (VSS), U31.3 (VSS), U32.3 (VSS), U33.3 (VSS), U34.3 (VSS), U35.3 (VSS), U36.3 (VSS), U37.3 (VSS), U38.3 (VSS), U39.3 (VSS), U40.3 (VSS), U41.3 (VSS), U42.3 (VSS), U43.3 (VSS), U44.3 (VSS), U45.3 (VSS), U46.3 (VSS), U47.3 (VSS), U48.3 (VSS), U49.3 (VSS), U50.3 (VSS), U51.3 (VSS), U52.3 (VSS), U53.3 (VSS), U54.3 (VSS), U55.3 (VSS), U58.3 (VSS); also elsewhere on the board
LED: U45.4 (DI); also elsewhere on the board
unnamed: U23.4 (DI), U40.2 (DO)
unnamed: U42.2 (DO), U43.4 (DI)
unnamed: U1.2 (DO), U2.4 (DI)
unnamed: U1.4 (DI), U18.2 (DO)
unnamed: U33.2 (DO), U41.4 (DI)
unnamed: U3.2 (DO), U4.4 (DI)
unnamed: U4.2 (DO), U5.4 (DI)
unnamed: U5.2 (DO), U6.4 (DI)
unnamed: U6.2 (DO), U7.4 (DI)
unnamed: U7.2 (DO), U8.4 (DI)
unnamed: U8.2 (DO), U9.4 (DI)
unnamed: U10.2 (DO), U11.4 (DI)
unnamed: U11.2 (DO), U12.4 (DI)
unnamed: U12.2 (DO), U13.4 (DI)
unnamed: U13.2 (DO), U14.4 (DI)
unnamed: U14.2 (DO), U15.4 (DI)
unnamed: U15.2 (DO), U16.4 (DI)
unnamed: U17.2 (DO), U18.4 (DI)
unnamed: U2.2 (DO), U19.4 (DI)
unnamed: U24.2 (DO), U25.4 (DI)
unnamed: U25.2 (DO), U26.4 (DI)
unnamed: U26.2 (DO), U27.4 (DI)
unnamed: U27.2 (DO), U28.4 (DI)
unnamed: U28.2 (DO), U29.4 (DI)
unnamed: U29.2 (DO), U30.4 (DI)
unnamed: U31.2 (DO), U32.4 (DI)
unnamed: U32.2 (DO), U33.4 (DI)
unnamed: U38.2 (DO), U39.4 (DI)
unnamed: U39.2 (DO), U40.4 (DI)
unnamed: U45.2 (DO), U46.4 (DI)
unnamed: U46.2 (DO), U47.4 (DI)
unnamed: U47.2 (DO), U48.4 (DI)
unnamed: U48.2 (DO), U49.4 (DI)
unnamed: U49.2 (DO), U50.4 (DI)
unnamed: U50.2 (DO), U51.4 (DI)
unnamed: U38.4 (DI), U58.2 (DO)
unnamed: U10.4 (DI), U52.2 (DO)
unnamed: U17.4 (DI), U53.2 (DO)
unnamed: U31.4 (DI), U55.2 (DO)
unnamed: U9.2 (DO), U52.4 (DI)
unnamed: U16.2 (DO), U53.4 (DI)
unnamed: U30.2 (DO), U55.4 (DI)
unnamed: U19.2 (DO), U20.4 (DI)
unnamed: U51.2 (DO), U58.4 (DI)
unnamed: U20.2 (DO), U21.4 (DI)
unnamed: U21.2 (DO), U22.4 (DI)
unnamed: U22.2 (DO), U24.4 (DI)
unnamed: U23.2 (DO), U34.4 (DI)
unnamed: U34.2 (DO), U35.4 (DI)
unnamed: U35.2 (DO), U36.4 (DI)
unnamed: U36.2 (DO), U37.4 (DI)
unnamed: U3.4 (DI), U37.2 (DO)
unnamed: U41.2 (DO), U42.4 (DI)
unnamed: U43.2 (DO), U44.4 (DI)
unnamed: U44.2 (DO), U54.4 (DI)
unnamed: JP6.2, U54.2 (DO)

Notes on the sheet:
per adafruit add big cap for onrush 1000uf 6.3v

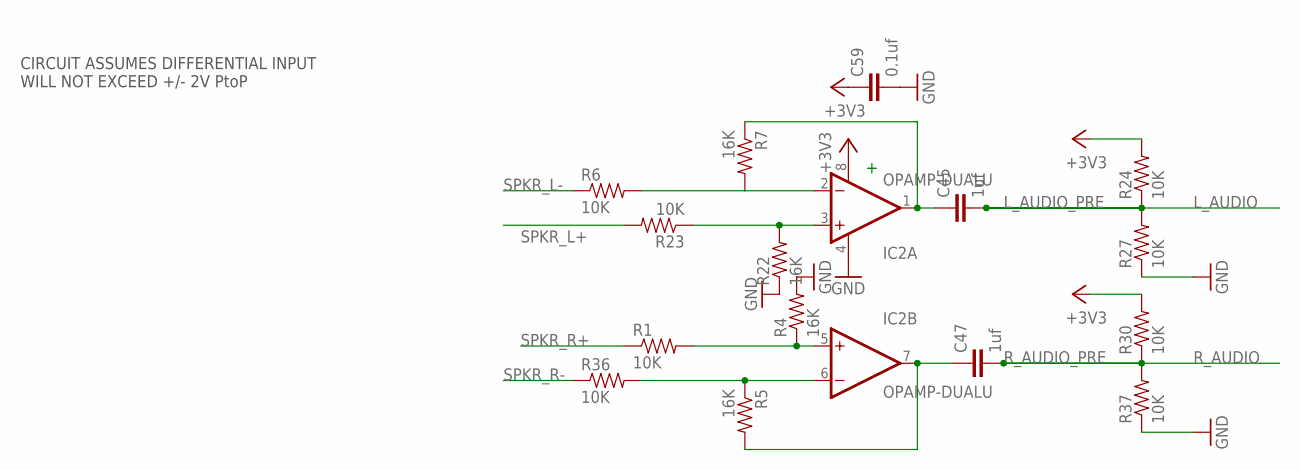
[picture p23: schematic Glowdeck_beta_proto.sch, sheet 9, SPK to AIN]

Parts:
C45, C47: 1uf; 0805
C59: 0.1uf; 0603-CAP
IC2: OPAMP-DUALU; SO08
R1, R6, R23, R24, R27, R30, R36, R37: 10K; 0603-RES
R4, R5, R7, R22: 16K; 0603-RES

Connections:
+3V3: C59.1, IC2.8 (V+), R24.2, R30.2; also elsewhere on the board
GND: C59.2, IC2.4 (V-), R4.2, R22.1, R27.1, R37.1; also elsewhere on the board
L_AUDIO: C45.2, R24.1, R27.2; also elsewhere on the board
L_AUDIO_PRE: C45.1, IC2.1 (OUT), R7.1
unnamed: IC2.5 (+IN), R1.2, R4.1
unnamed: IC2.6 (-IN), R5.1, R36.2
unnamed: IC2.3 (+IN), R22.2, R23.1
unnamed: IC2.2 (-IN), R6.2, R7.2
R_AUDIO: C47.2, R30.1, R37.2; also elsewhere on the board
R_AUDIO_PRE: C47.1, IC2.7 (OUT), R5.2
SPKR_L+: R23.2; also elsewhere on the board
SPKR_L-: R6.1; also elsewhere on the board
SPKR_R+: R1.1; also elsewhere on the board
SPKR_R-: R36.1; also elsewhere on the board

Notes on the sheet:
CIRCUIT ASSUMES DIFFERENTIAL INPUT WILL NOT EXCEED +/- 2V PtoP

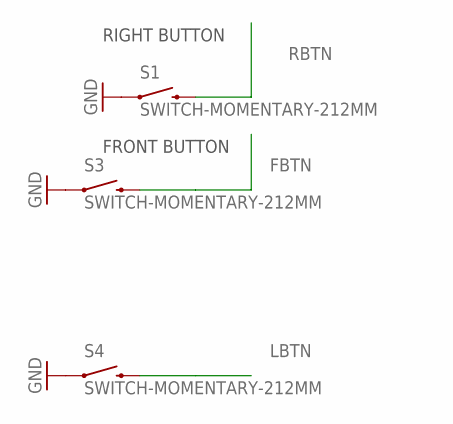
[picture p24: schematic Glowdeck_beta_proto.sch, sheet 10, TACT]

Parts:
S1, S3, S4: SWITCH-MOMENTARY-212MM; TACTILE-PTH-12MM

Connections:
FBTN: S3.3 (2); also elsewhere on the board
GND: S1.1, S3.1, S4.1; also elsewhere on the board
LBTN: S4.3 (2); also elsewhere on the board
RBTN: S1.3 (2); also elsewhere on the board

Notes on the sheet:
RIGHT BUTTON
FRONT BUTTON

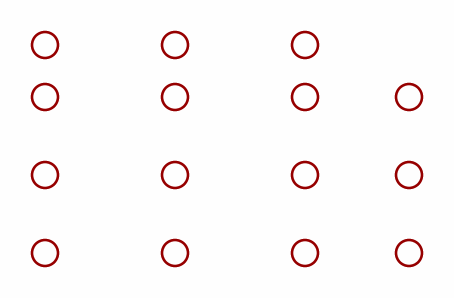
[picture p25: schematic Glowdeck_beta_proto.sch, sheet 11]

Parts:
STANDOFF1, STANDOFF2, STANDOFF3, STANDOFF4, STANDOFF5, STANDOFF6, STANDOFF7, STANDOFF8, STANDOFF9, STANDOFF10, STANDOFF11, STANDOFF12, STANDOFF13, STANDOFF14, STANDOFF15: STAND-OFF

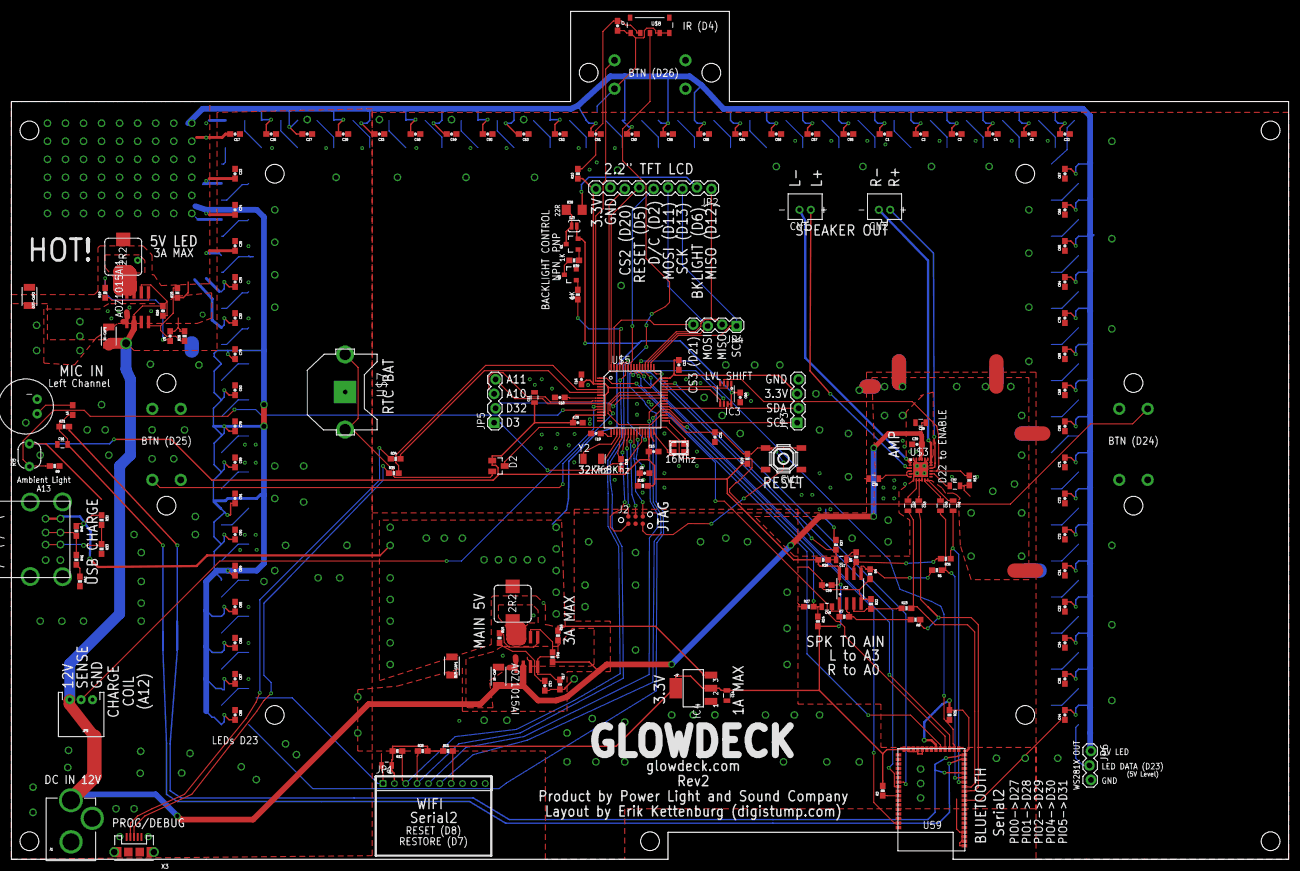
[picture p26: board Glowdeck_beta_proto.brd from above]

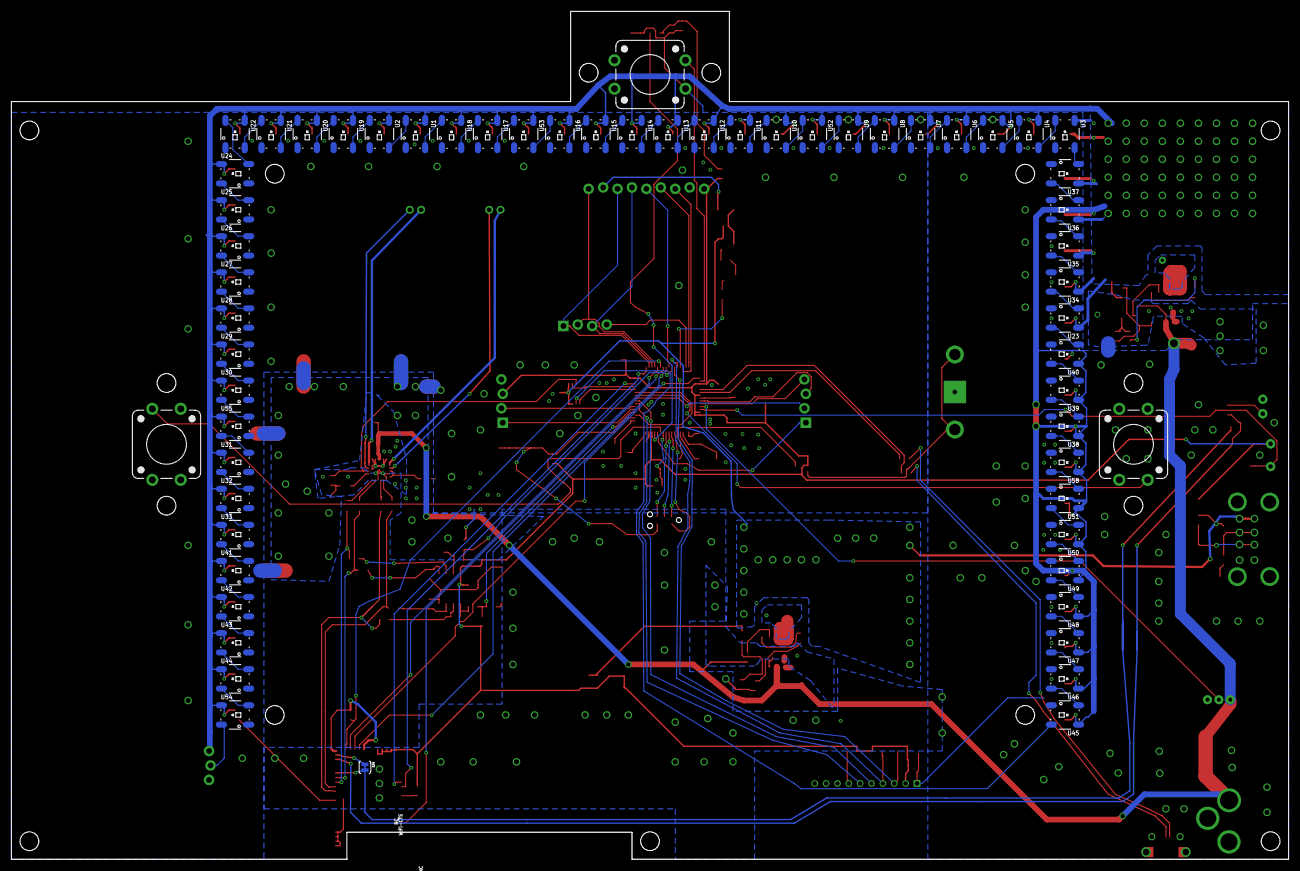
[picture p27: board Glowdeck_beta_proto.brd from below]

Board: 2 copper layers, 224.8 x 149.2 mm, 239 parts (60 on the bottom side), 162 nets.
